garyStofer/DS2502_DELL_PS/CAD_files/DS2502_prog.brd

## EAGLE design CAD_files/DS2502_prog.brd (2015-09-18)

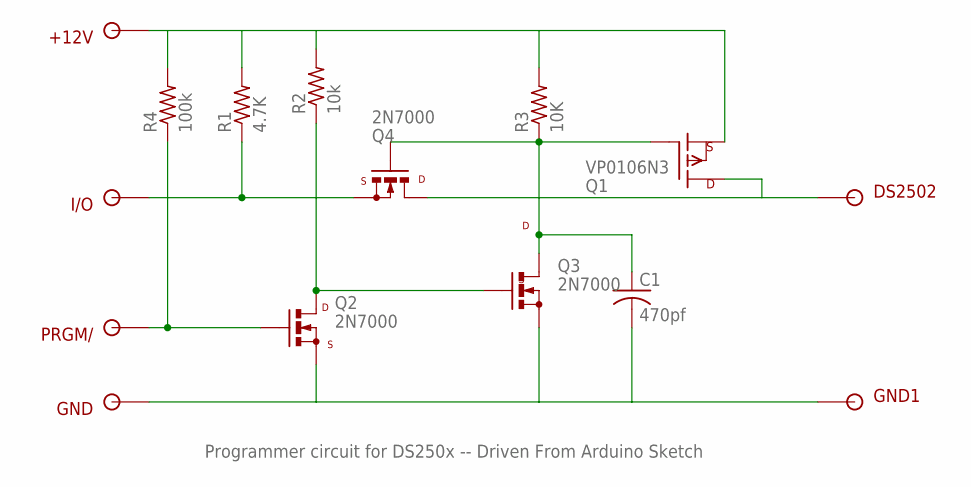
[picture p1: schematic DS2502_prog.sch]

Parts:
+12V: SOLDER_POINTA; P1-13
C1: 470pf; C025-025X050
DS2502: SOLDER_POINTA; P1-13
GND, GND1: SOLDER_POINTA; P1-13
I/O: SOLDER_POINTA; P1-13
PRGM/: SOLDER_POINTA; P1-13
Q1: VP0106N3; TO92-
Q2, Q3, Q4: 2N7000; TO92-LINE
R1: 4.7K; 0207/2V
R2: 10k; 0309/10
R3: 10K; 0207/2V
R4: 100k; 0309/10

Connections:
unnamed: +12V.1, Q1.3 (S), R1.2, R2.2, R3.2, R4.2
unnamed: I/O.1, Q4.3 (S), R1.1
unnamed: Q2.1 (D), Q3.2 (G), R2.1
unnamed: PRGM/.1, Q2.2 (G), R4.1
unnamed: C1.2, GND.1, GND1.1, Q2.3 (S), Q3.3 (S)
unnamed: C1.1, Q1.2 (G), Q3.1 (D), Q4.2 (G), R3.1
unnamed: DS2502.1, Q1.1 (D), Q4.1 (D)

Notes on the sheet:
Programmer circuit for DS250x -- Driven From Arduino Sketch

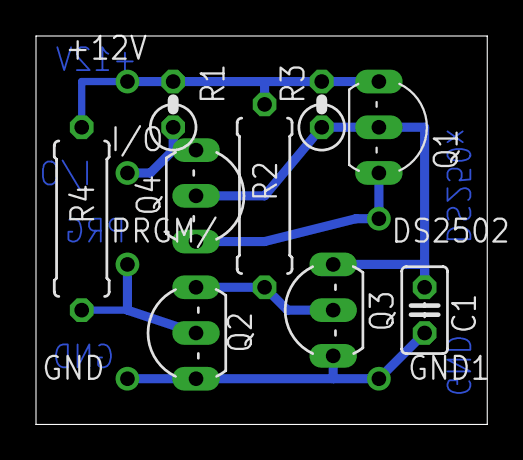
[picture p2: board DS2502_prog.brd from above]

Board: 2 copper layers, 25.1 x 21.6 mm, 15 parts (0 on the bottom side), 7 nets.
