garyStofer/DS2502_DELL_PS/(threads)

Thread 3 (2023-02-26):

Recommendation of mosfets

kerim92, 2023-02-26:
Hello,
i wanted to write DS2501's and build pcb a little bit smaller than currently.

can i use 2n7002 sot-23 instead of 2n7000 to-92?
can i use AO3413L-SOT23-3 P channel mosfet instead of vp0106n3?
other case is i wanted to use 0402 resistors

Properties of AO3413 P channel Mosfet
    VDS (V) = -20V
    ID = -3 A
    RDS(ON) < 97mΩ (VGS = -4.5V)
    RDS(ON) < 130mΩ (VGS = -2.5V)
    RDS(ON) < 190mΩ (VGS = -1.8V)

Properties of 2N7002 Mosfet
   60V 3Ohms 240mA Rds(ON) 3 at VGS = 10 V Enhancement mode

can you please check?
thank you very much for build such as project.
thank you!

garyStofer, 2023-02-26:
Hi --

the properties of the mosfets are not terribly critical – if you choose a FET of the same kind and with roughly the same characteristics it will work just fine.   The fets in my example were chosen simply because I had them already.

I would stay away of the 402 size resistors and go for the 603 ones . I find working with the 402’s is quite difficult and not worth the trouble.

I have had no luck recently to buy the 1-Wire EPROM/OTP  devices. I just ordered a couple of EE-PROMs to see if I can make them working with the laptops.  Hopefully the laptops don’t interrogate the CHIP ID.

If you make a nice PCP and upload it to OSH–PCB as a public board with documentation I will ad a link to my github for it.

Thanks

Gary

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

kerim92, 2023-02-28:
Hi Gary,
Thank you very much for fast response.
Actually i love 0402 cause they are small and easy to find on notebook motherboards.
I only think about wattage of 0402's i will check and see of no problem with 0402 i will let you know.

i do not think about main system's checking for chip id... i think main system looking for data only but this is my think.
I have bought already programmed DS2501 series from Chinese suppliers they work very fine.

I will upload my OSH–PCB files to this project if device works fine.
Lets see our empty chips able to work or not.

Thank you,
Have a nice day

garyStofer, 2023-02-28:
I’m not familiar with DS2501.   We have been using the DS2502+ in replacement of DS2502.

G

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

Thread 4 (2023-03-04):

DS2502 and DS28E07+ 1 Wire Programming Issue

sanjeevirm, 2023-03-04:
We have procured DS2502 and DS28E07+ and we have facing the writing programming issue.

We have connected **Arduino uno to 1 wire DS2502 or DS28E07+ device** but we can't write the device.

Please help us how the set up we need make and  how to write the 1 Wire EEPROM. or (please share me the setup image)

For actually our main aim is to write the dell charger ID value into the EEPROM (Charging the laptop)

Please help us we have struggled last one month . please provide the email ID

garyStofer, 2023-03-04:
First of, only the DS2502 device is recognized by the Arduino code and the DELL laptops – Other devices will not program or work.

What did the ARDUINO program display in the debug monitor when you run it.  ?? Did it say “no device detected ?

You should see the schematic for the programmer device from the GIT – You need to make that circuit exactly as drawn – connections from the Arduinio  ( Pro-mini) are given in the sketch via #defines at the top of the file.   You can buy a PCB for the circuit from OSHpark.com at https://oshpark.com/shared_projects/l4VC80Px
Hope that helps
gary
Sent: Saturday, March 04, 2023 12:08 AM
To: garyStofer/DS2502_DELL_PS
Cc: Subscribed
Subject: [garyStofer/DS2502_DELL_PS] DS2502 and DS28E07+ 1 Wire Programming Issue (Issue #4)

We have procured DS2502 and DS28E07+ and we have facing the writing programming issue.

We have connected Arduino uno to 1 wire DS2502 or DS28E07+ device but we can't write the device.

Please help us how the set up we need make and how to write the 1 Wire EEPROM. or (please share me the setup image)

For actually our main aim is to write the dell charger ID value into the EEPROM (Charging the laptop)

Please help us we have struggled last one month . please provide the email ID

—
Reply to this email directly, view it on GitHub, or unsubscribe.
You are receiving this because you are subscribed to this thread.Message ID: ***@***.***>

sanjeevirm, 2023-03-08:
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
Hi Gary,
Thanks for your valuable support to us.

Actually we are doing the separate charging station for dell laptop. so we want to write the dell charger ID into the DS2502 IC.
for that we have used above circuit ,by using your code to flash the charger IC its working while connecting with Arduino ,
After flashing the IC  once we remove "the "Arduino UNO Board" charging is not happened, while we separately using the ic in our custom board(charging adapter)

what we observed is the dell charger id is not flashed on the ic , it will be dump in the Arduino board itself,
we need example code to flash the charger id directly into the ds2502 ic with arduino, so that we can use the ic seperately in our board... if possible plz share ur circuit connection image...

garyStofer, 2023-03-08:
You have to use my schematic for the programmer exactly. You can not just program the device with the 3.3 v from the arguing. It requires 12v for programming, hence the need for the extra circuit.  Look at the schematic on the Git and duplicate that circuit. You can order the PCB from Oshpark pcb if you want to .

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

inglisp, 2023-03-09:
Hi,

I can confirm Gary's circuit is good and we have used it for many years.
I will take a photo of our setup and send it to you.

Regards

Paul

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

sanjeevirm, 2023-03-10:
> Hi, I can confirm Gary's circuit is good and we have used it for many years. I will take a photo of our setup and send it to you. Regards Paul
> […](#)
> On Thu, 9 Mar 2023, 17:30 Gary Stofer, ***@***.***> wrote: I don’t see the 12V connection from the power supply to the arduino DC input. Yes , pin 6 and 7 are pulled up to the 12V programming rail by R4 and R1, but the Arduino chip running at +5V from it’s regulator should clamp that to 5V through its protection diodes. If the CPU got hot then you might have something wrong with the FETs that a hard 12V gets back to the I/O pin. Maybe Q1 in wrong or shorted ? Check all the FETS and make sure they are in correctly orientatted and the right types. I would first see if the Arduino chip still works, Is the diagnostic output showing something ? Can you still program it. Then run a sketch on it and see if you still can toggle pin6 and pin7 using a LED with a 300Ohm resitor connected to these pins. If that works then your arduino chip is still useable, otherwise get a new chip and replace it. You might want to take Q1 out of the circuit and see if you can read the DS2502 attached to it. The normal read/write operation is that Q3 is open and Q4’s Gate is pulled up to 12V through R3 making it conductive. To program a byte the 12V gets switched on via Q3 Drain going low making Q1 conduct. This is a 0.5ms pulse. Quite a few people have successfully copied this design and got it working , so I’m sure you figure out what’s wrong. Gary From: sanjeevirm Sent: Thursday, March 09, 2023 4:49 AM To: garyStofer/DS2502_DELL_PS Cc: Gary Stofer ; Comment Subject: Re: [garyStofer/DS2502_DELL_PS] DS2502 and DS28E07+ 1 Wire Programming Issue (Issue #4) Hi Gary, Thanks for your support and sorry for inconvenience. As per your suggestion we done the same setup to programming the DS2502 but we are facing the issue IO line and programming line connected to Arduino return 12V supply going on that particular pin. after Arduino IC over heated up. and we connected the common GND and 12V supply taken from the external Power supply. And please find the attached we done the setup image have any mistake any connections or anything we done wrongly. Please help us. Thanks Sanjeev — Reply to this email directly, view it on GitHub, or unsubscribe. You are receiving this because you commented.Message ID: ***@***.***> — Reply to this email directly, view it on GitHub <[#4 (comment)](https://github.com/garyStofer/DS2502_DELL_PS/issues/4#issuecomment-1462469729)>, or unsubscribe <https://github.com/notifications/unsubscribe-auth/AIQR55RMPS6L4D3JEREDE3DW3IHSDANCNFSM6AAAAAAVPNC2CQ> . You are receiving this because you are subscribed to this thread.Message ID: ***@***.***>

sanjeevirm, 2023-03-10:
Hi thanks for your valuable support.

Please share me the Setup image for programming circuit.

Thanks
Sanjeevi.R

garyStofer, 2023-03-14:
I don’t have a picture to show you. The picture you sent before was essentially correct , except that you didn’t have the +12V feed going to the arduino  +12V input .

G

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

sanjeevirm, 2023-03-23:
Hi Gary,
Thanks for your well support and as per your instruction we done all the things now we got some results.
DS2502 We can able to read the ROM ID and showing device present.

But we CRC command error and value error.

please find the attached screen shot of serial monitor output image for your reference .
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

Thanks
R.MSanjeevi

garyStofer, 2023-03-23:
I see you are getting 0xff back after a program instruction.

Either the programming voltage 12v is not getting to the chip and your readback is the initial unprogrammed stated of the chip, or the chip somehow got programmed to all F's . The fact that you can read the chip signature tells me that reading of the device works well.

I don't remember exactly when and how long the 12v pulse gets applied to the chip during programming, but it should be evident looking at the code. If you have a scope it would be best to hook it up to the chip and verify the signaling on the chip.

Remember , the Ds2502 device is a one time programmable device. It can not be erased and reprogrammed. So if it got programmed to the wrong value before it's of no use anymore.

Hope this helps.

G

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

Closed 2023-03-10.

Thread 5 (2024-02-09):

DS2502 returns FF

jensvanhoof86, 2024-02-09:
Hi,

I built the programming circuit on a breadboard in an attempt to program a DS2502 with an Arduino Uno.

It seems like the sketch communicates correctly with the DS2502 but the read back always returns 0xFF, like none of the bytes are acutally written:

`Nothing connected
device present
ROM  Data is:
9 10 5F 31 A 0 0 C0 .
ROM CRC matches
Device ID  DS2502 found
PROG Memory
programmed data:  44 read back: FF
programmed data:  45 read back: FF
programmed data:  4C read back: FF
programmed data:  4C read back: FF
programmed data:  30 read back: FF
programmed data:  30 read back: FF
programmed data:  41 read back: FF
programmed data:  43 read back: FF
programmed data:  30 read back: FF
programmed data:  39 read back: FF
programmed data:  30 read back: FF
programmed data:  31 read back: FF
programmed data:  39 read back: FF
programmed data:  35 read back: FF
programmed data:  30 read back: FF
programmed data:  34 read back: FF
programmed data:  36 read back: FF
programmed data:  43 read back: FF
programmed data:  4E read back: FF
programmed data:  30 read back: FF
programmed data:  39 read back: FF
programmed data:  54 read back: FF
Reading Memory
Invalid command CRC!
Calculated CRC:8D
DS250x readback CRC:FF
Stopped!!
`

Any ideas what could be wrong?

garyStofer, 2024-02-09:
Hi , looks like the part is not getting programmed.., is the circuit correct ?? If the device doesn't get the proper programming voltage during the programming phase this would be the result.  An empty part reads all FF , except for the device signature. Gary On Feb 9, 2024, at 4:24 AM, jensvanhoof86 ***@***.***> wrote:
Hi,
I built the programming circuit on a breadboard in an attempt to program a DS2502 with an Arduino Uno.
It seems like the sketch communicates correctly with the DS2502 but the read back always returns 0xFF, like none of the bytes are acutally written:
Nothing connected device present ROM  Data is:  9 10 5F 31 A 0 0 C0 . ROM CRC matches  Device ID  DS2502 found PROG Memory programmed data:  44 read back: FF programmed data:  45 read back: FF programmed data:  4C read back: FF programmed data:  4C read back: FF programmed data:  30 read back: FF programmed data:  30 read back: FF programmed data:  41 read back: FF programmed data:  43 read back: FF programmed data:  30 read back: FF programmed data:  39 read back: FF programmed data:  30 read back: FF programmed data:  31 read back: FF programmed data:  39 read back: FF programmed data:  35 read back: FF programmed data:  30 read back: FF programmed data:  34 read back: FF programmed data:  36 read back: FF programmed data:  43 read back: FF programmed data:  4E read back: FF programmed data:  30 read back: FF programmed data:  39 read back: FF programmed data:  54 read back: FF Reading Memory Invalid command CRC! Calculated CRC:8D DS250x readback CRC:FF Stopped!!
Any ideas what could be wrong?

—Reply to this email directly, view it on GitHub, or unsubscribe.You are receiving this because you are subscribed to this thread.Message ID: ***@***.***>

jensvanhoof86, 2024-03-04:
yeah I feel like something is wrong with my circuit but I still haven't been able to figure it out.
Is it correct that PRGM and I/O are pulled-up to 12V instead of the 5V/3.3V that the arduino uses? In the DS2502 datasheet they make a difference between VDD and 12V. I'm wondering if I have not killed anything on the arduino meanwhile.

jensvanhoof86, 2024-03-04:
stop the presses! turns out I had 2 out of 3 mosfets broken! It works now!! Thanks a lot for the reply.

for future readers: I have connected R4, R1 and R2 to 5V instead of 12V. only R3 goes to the 12V.

garyStofer, 2024-03-04:
Good job – Glad you figured it out !

G

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
