garyStofer/DS2502_DELL_PS/(commit log)

2015-09-18 Added CAD files and included link to PCB from OSH
    [DS2502_prog.brd, DS2502_prog.sch]
2018-10-30 added #defines for pins and change so that it connects to an Arduino on a Air_LCD board -- Enabled a LED for display while programming
2018-10-30 added captured response trace from Onewire device
2023-02-28 Added defines for pins used to control circuit added define to not program -- only read added better printout for read data and device ID changed serial connection speed to the standard 115200 bd
2023-03-01 fixed warning about const char *
    [DS2502_DELL_PS.ino]
